xlisp/pot_lid_antenna_holder/天线锅.png

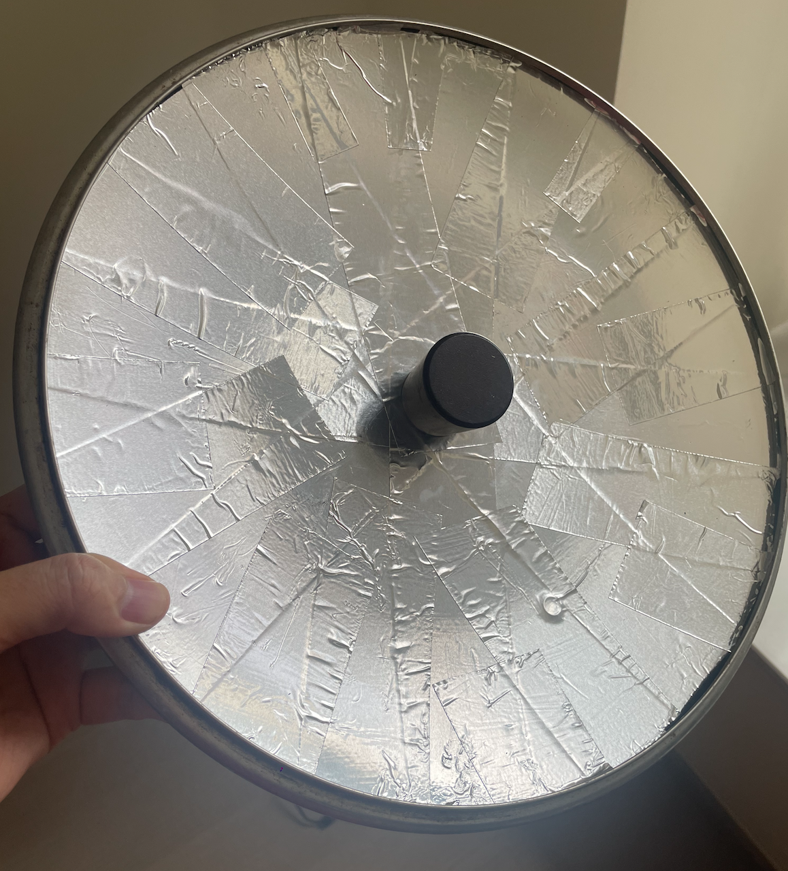
天线锅.png
