xlisp/pot_lid_antenna_holder/1_base.stl

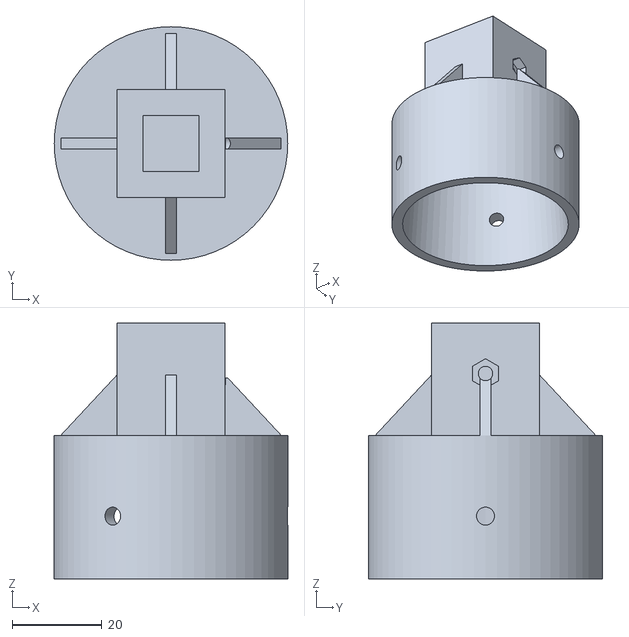
[picture p2: CAD file, 2026-11-07]
1_base.stl
52.0 x 52.0 x 57.0
