xlisp/pot_lid_antenna_holder/3_slider.stl

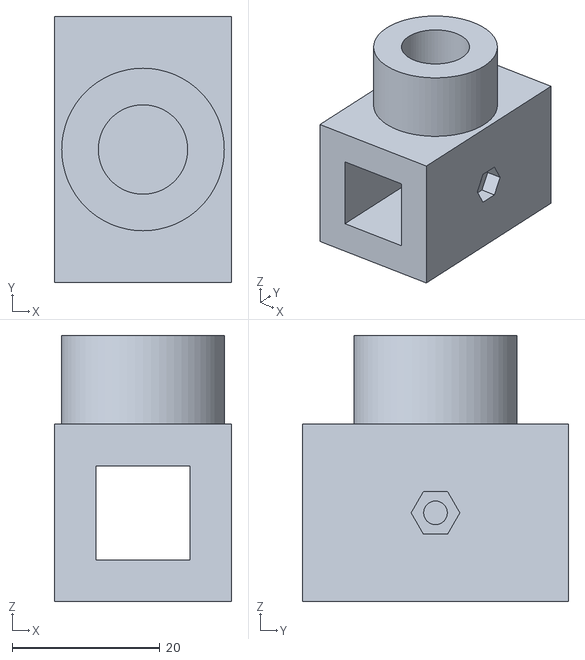
[picture p3: CAD file, 2026-11-07]
3_slider.stl
24.0 x 36.0 x 36.0
