xlisp/pot_lid_antenna_holder/6_cradle.stl

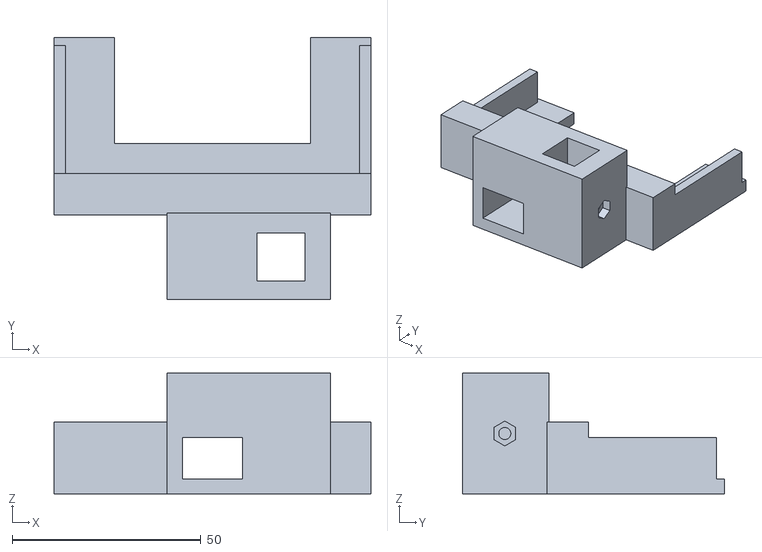
[picture p4: CAD file, 2026-11-07]
6_cradle.stl
84.0 x 69.3 x 32.0
