xlisp/pot_lid_antenna_holder/4_tray.stl

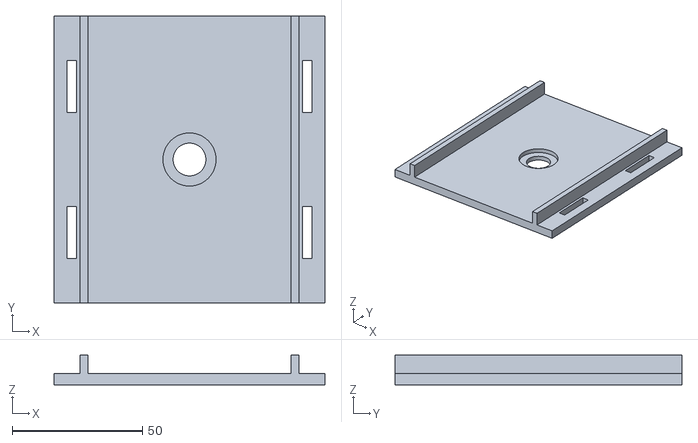
[picture p5: CAD file, 2026-11-07]
4_tray.stl
104.0 x 110.0 x 11.5
