xlisp/pot_lid_antenna_holder/2_rod.stl

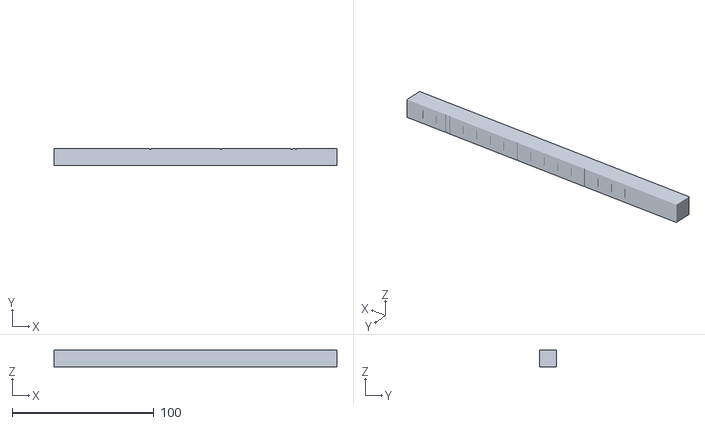
[picture p6: CAD file, 2026-11-07]
2_rod.stl
200.0 x 12.0 x 12.0
