xlisp/pot_lid_antenna_holder/5_pin.stl

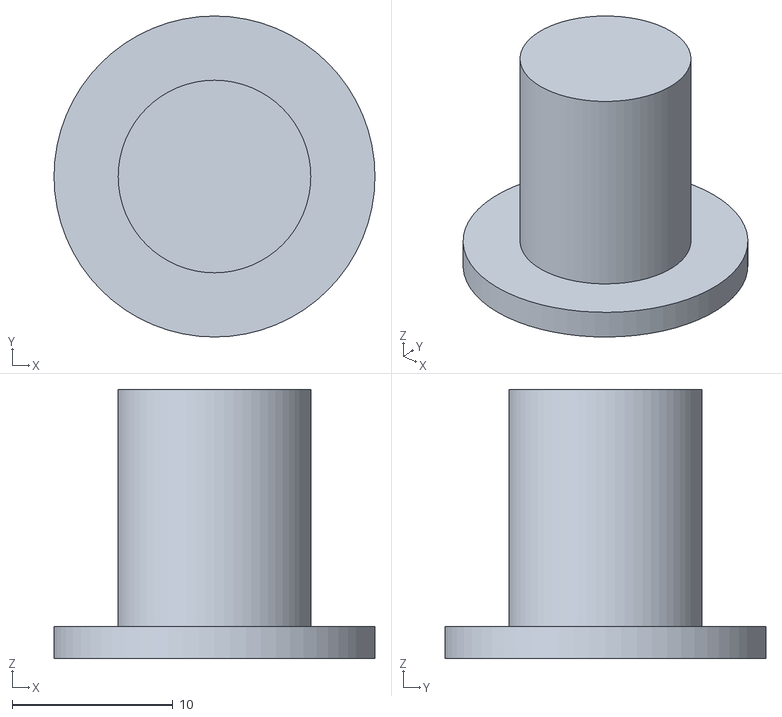
[picture p7: CAD file, 2026-11-07]
5_pin.stl
20.0 x 20.0 x 16.8
