xlisp/pot_lid_antenna_holder/(commit log)

2026-11-07 我现在要做个手机热点辐射天线，拿一个凹面玻璃锅盖，上面贴上铝箔贴纸，手机放中间，然后手机放锅盖中心，
    [1_base.stl, 2_rod.stl, 3_slider.stl, 4_tray.stl, 5_pin.stl]
2026-11-07 2_rod.stl 需要改一下,因为我锅这边我把原来的拧盖反过来拧了,这样固定支架更加稳定。 我量了一下，4mm，这边做一个圆柱套筒，就比较稳固，再热熔胶固定一下就不错。不过这个拧盖的是个梯形圆柱体。
    [1_base.stl, 2_rod.stl]
2026-11-07 旋钮顶面的直径 就是 4cm, 旋钮从玻璃面到顶面的高度：约 2.6cm . 需要留点余地，不然套不上去，
    [1_base.stl, 2_rod.stl]
2026-11-07 改小一点，不然要打三个小时
    [1_base.stl, 2_rod.stl, 3_slider.stl]
2026-11-07 手机托架，6_cradle.stl
    [4_tray.stl, 6_cradle.stl]
2026-11-07 改一下大小
    [1_base.stl, 3_slider.stl, 6_cradle.stl]
